hxssank/shaggy/hardware/pcb/preview/shaggy-3d.png

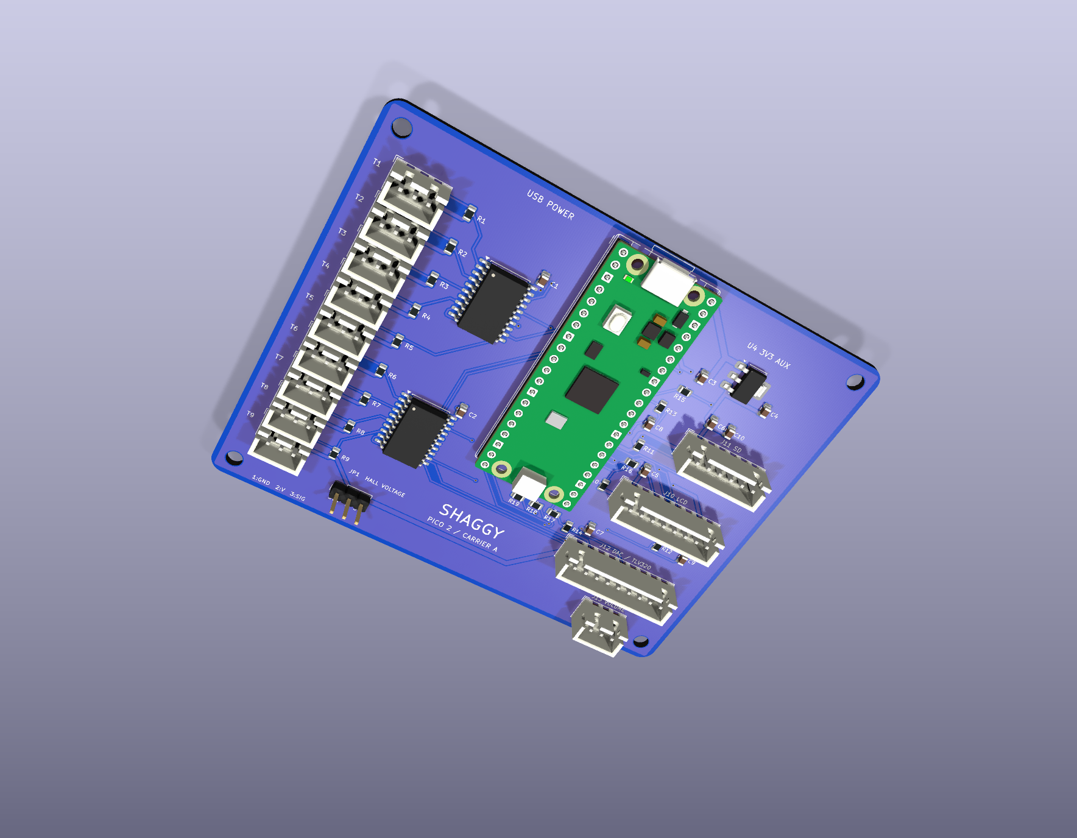
hardware/pcb/preview/shaggy-3d.png
