hxssank/shaggy/hardware/pcb/preview/shaggy-top.png

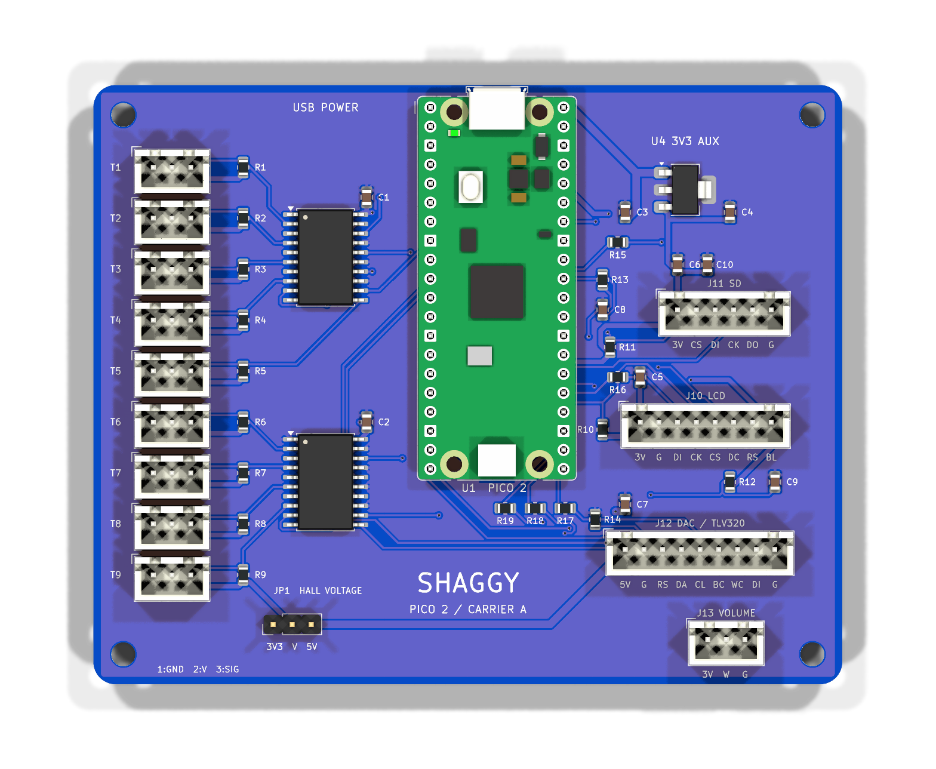
hardware/pcb/preview/shaggy-top.png
