hxssank/shaggy/hardware/pcb/shaggy-carrier.step

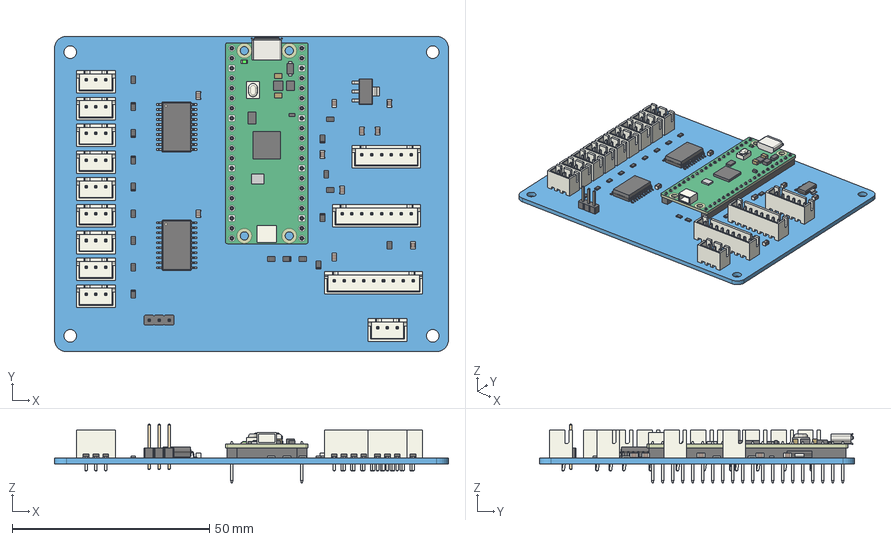
[picture p3: CAD file, 2026-11-09]
hardware/pcb/shaggy-carrier.step
100.0 x 80.0 x 14.9 mm
SOIC-20W_7.5x12.8mm_P1.27mm x 2
R_0805_2012Metric x 19
C_0805_2012Metric x 10
JST_B3B_XH_A x 10
SOT-223
RaspberryPi_Pico_H_Module_KiCad
RaspberryPi_Pico_Header_DIP-40_H2.54mm_KiCad
JST_B9B_XH_A
PinHeader_1x03_P254mm_Vertical
JST_B6B_XH_A
JST_B8B_XH_A
shaggy-carrier_PCB
