hxssank/shaggy/(list of files, drawings)

Other design files:
hardware/pcb/reports/pcb-drc.json
hardware/pcb/reports/schematic-erc.json
