hxssank/shaggy/hardware/pcb/shaggy-carrier.kicad_pcb

## KiCad design hardware/pcb/shaggy-carrier.kicad_pcb (2026-11-09)

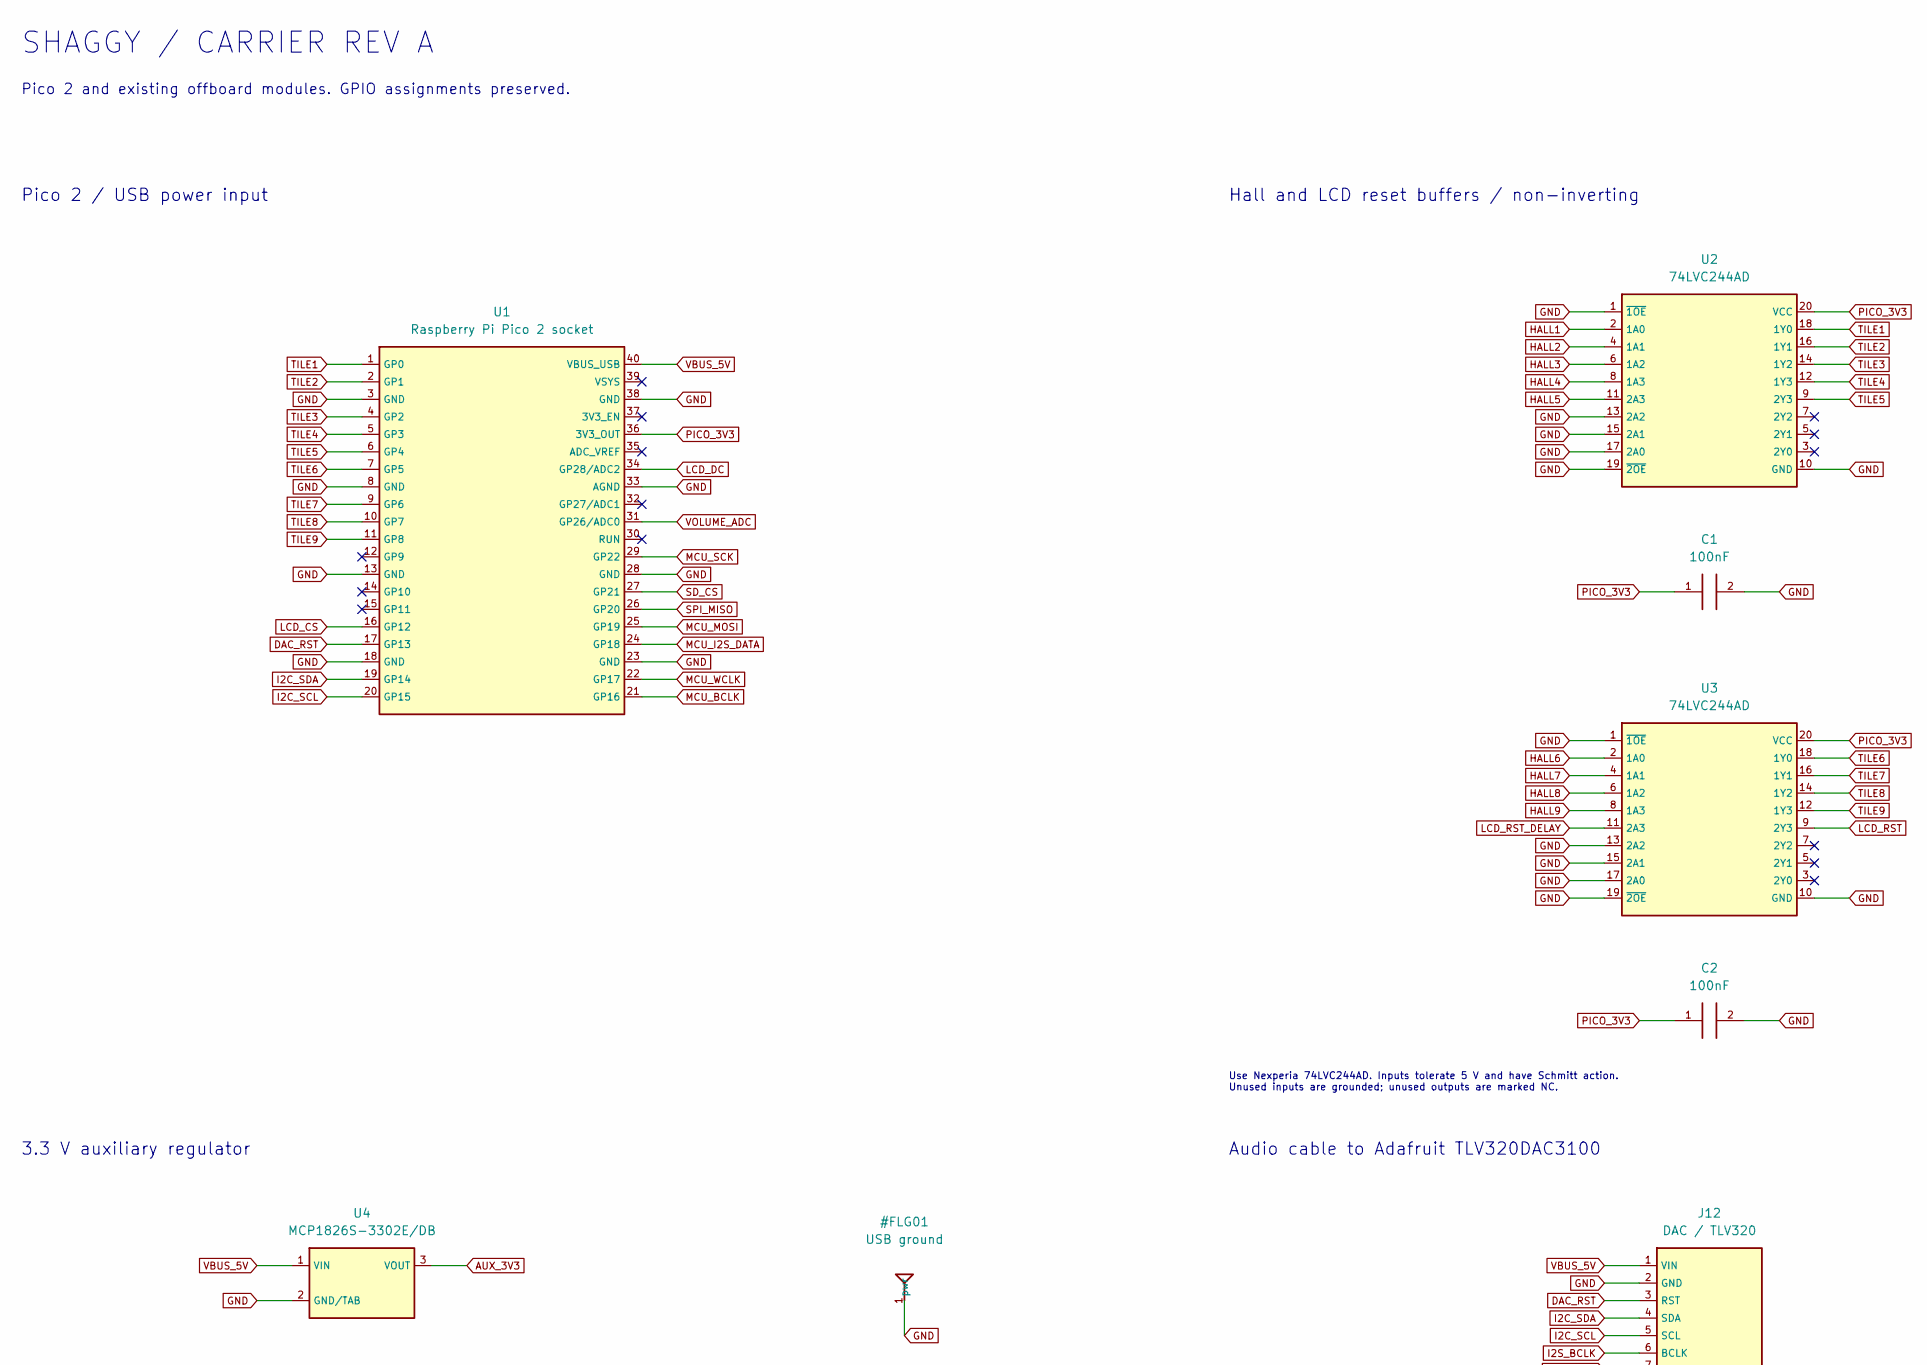
[picture p5: schematic shaggy-carrier.kicad_sch, Shaggy breadboard replacement, part in row 1, column 1]

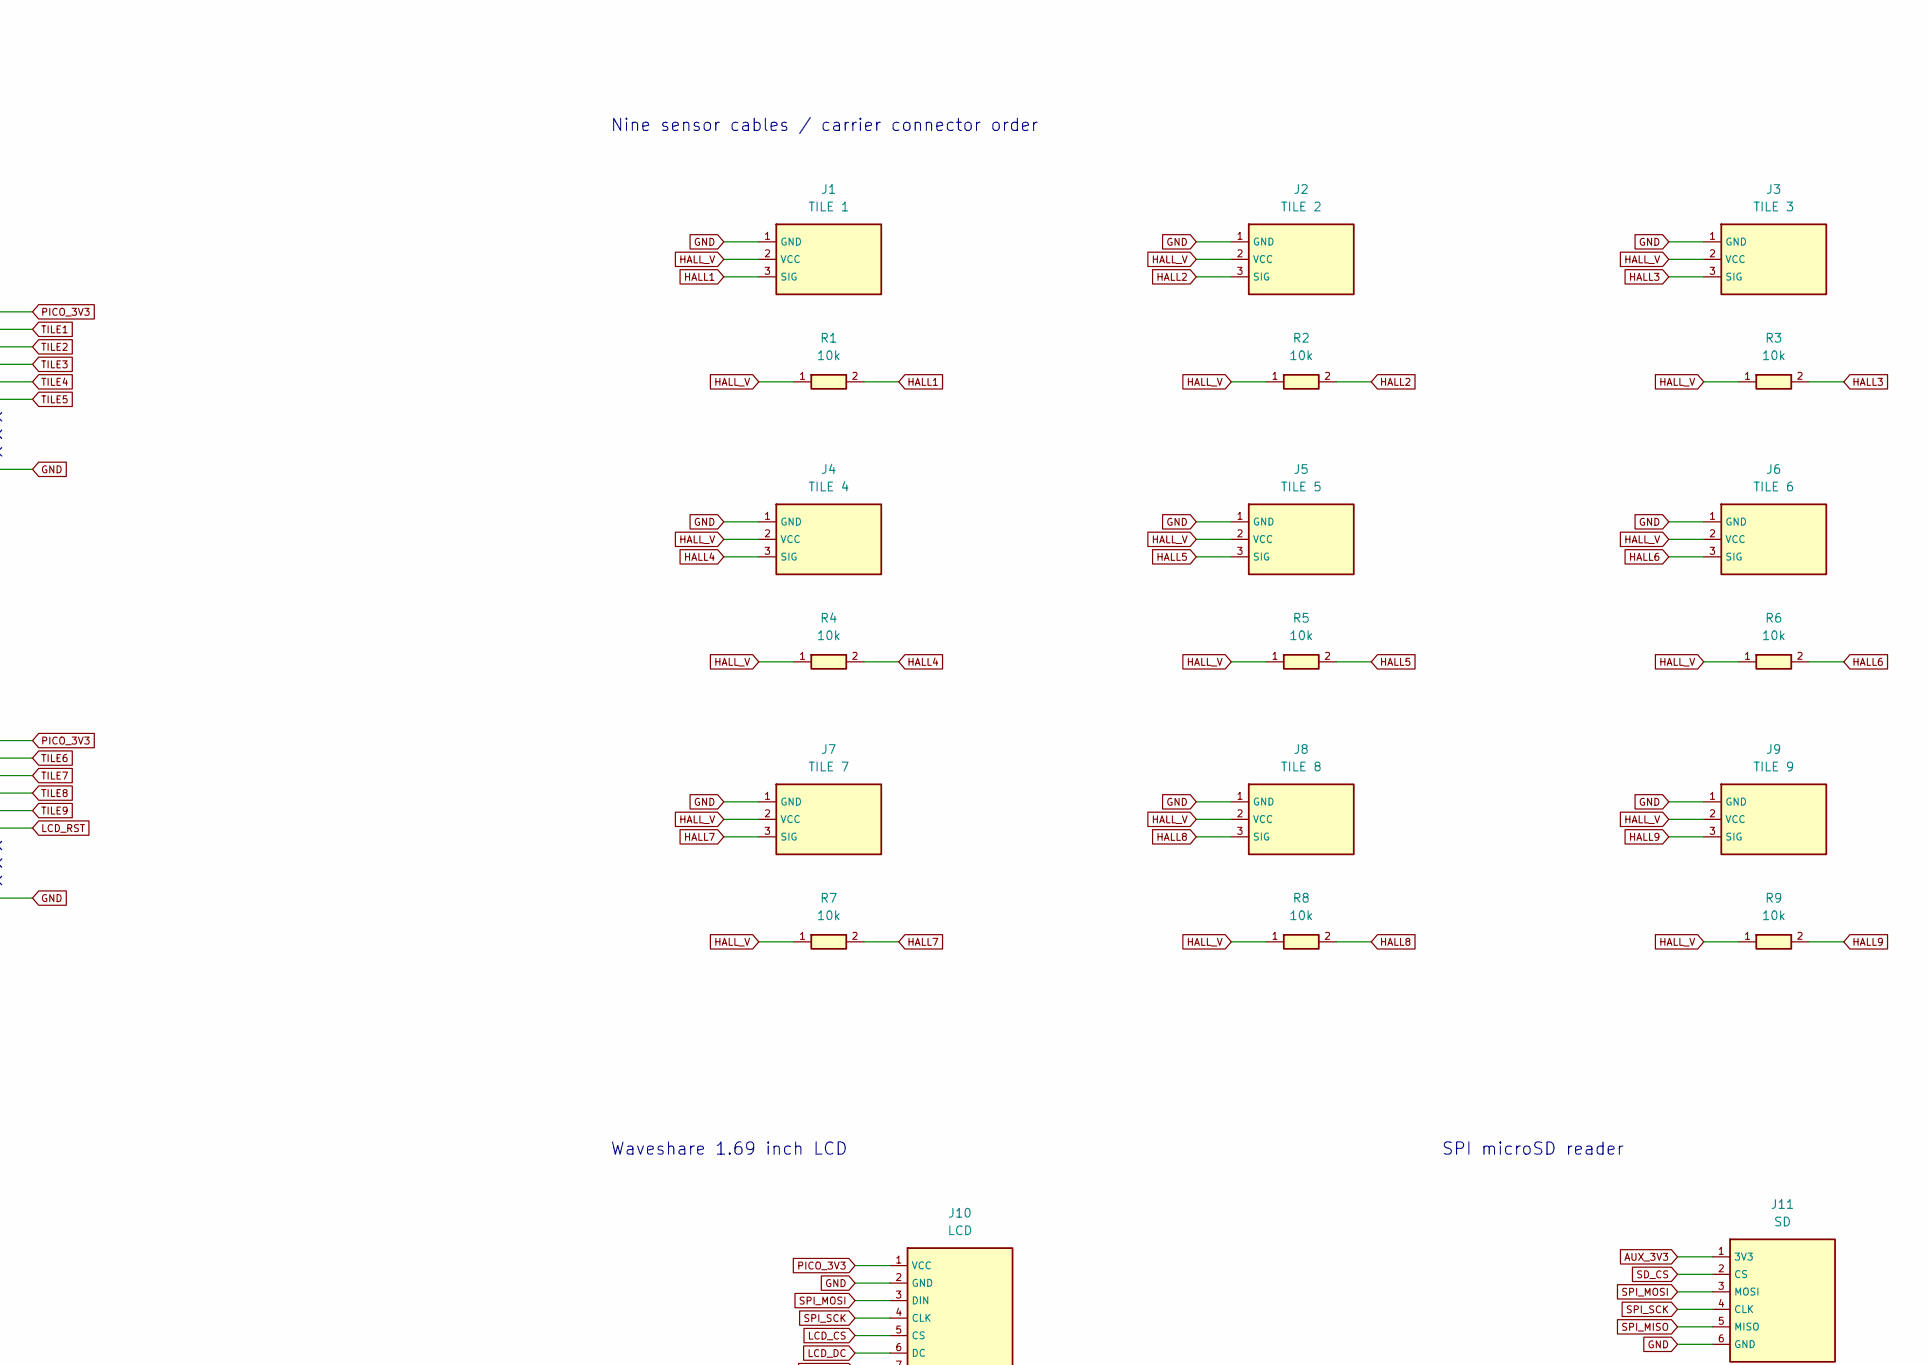
[picture p6: schematic shaggy-carrier.kicad_sch, Shaggy breadboard replacement, part in row 1, column 2]

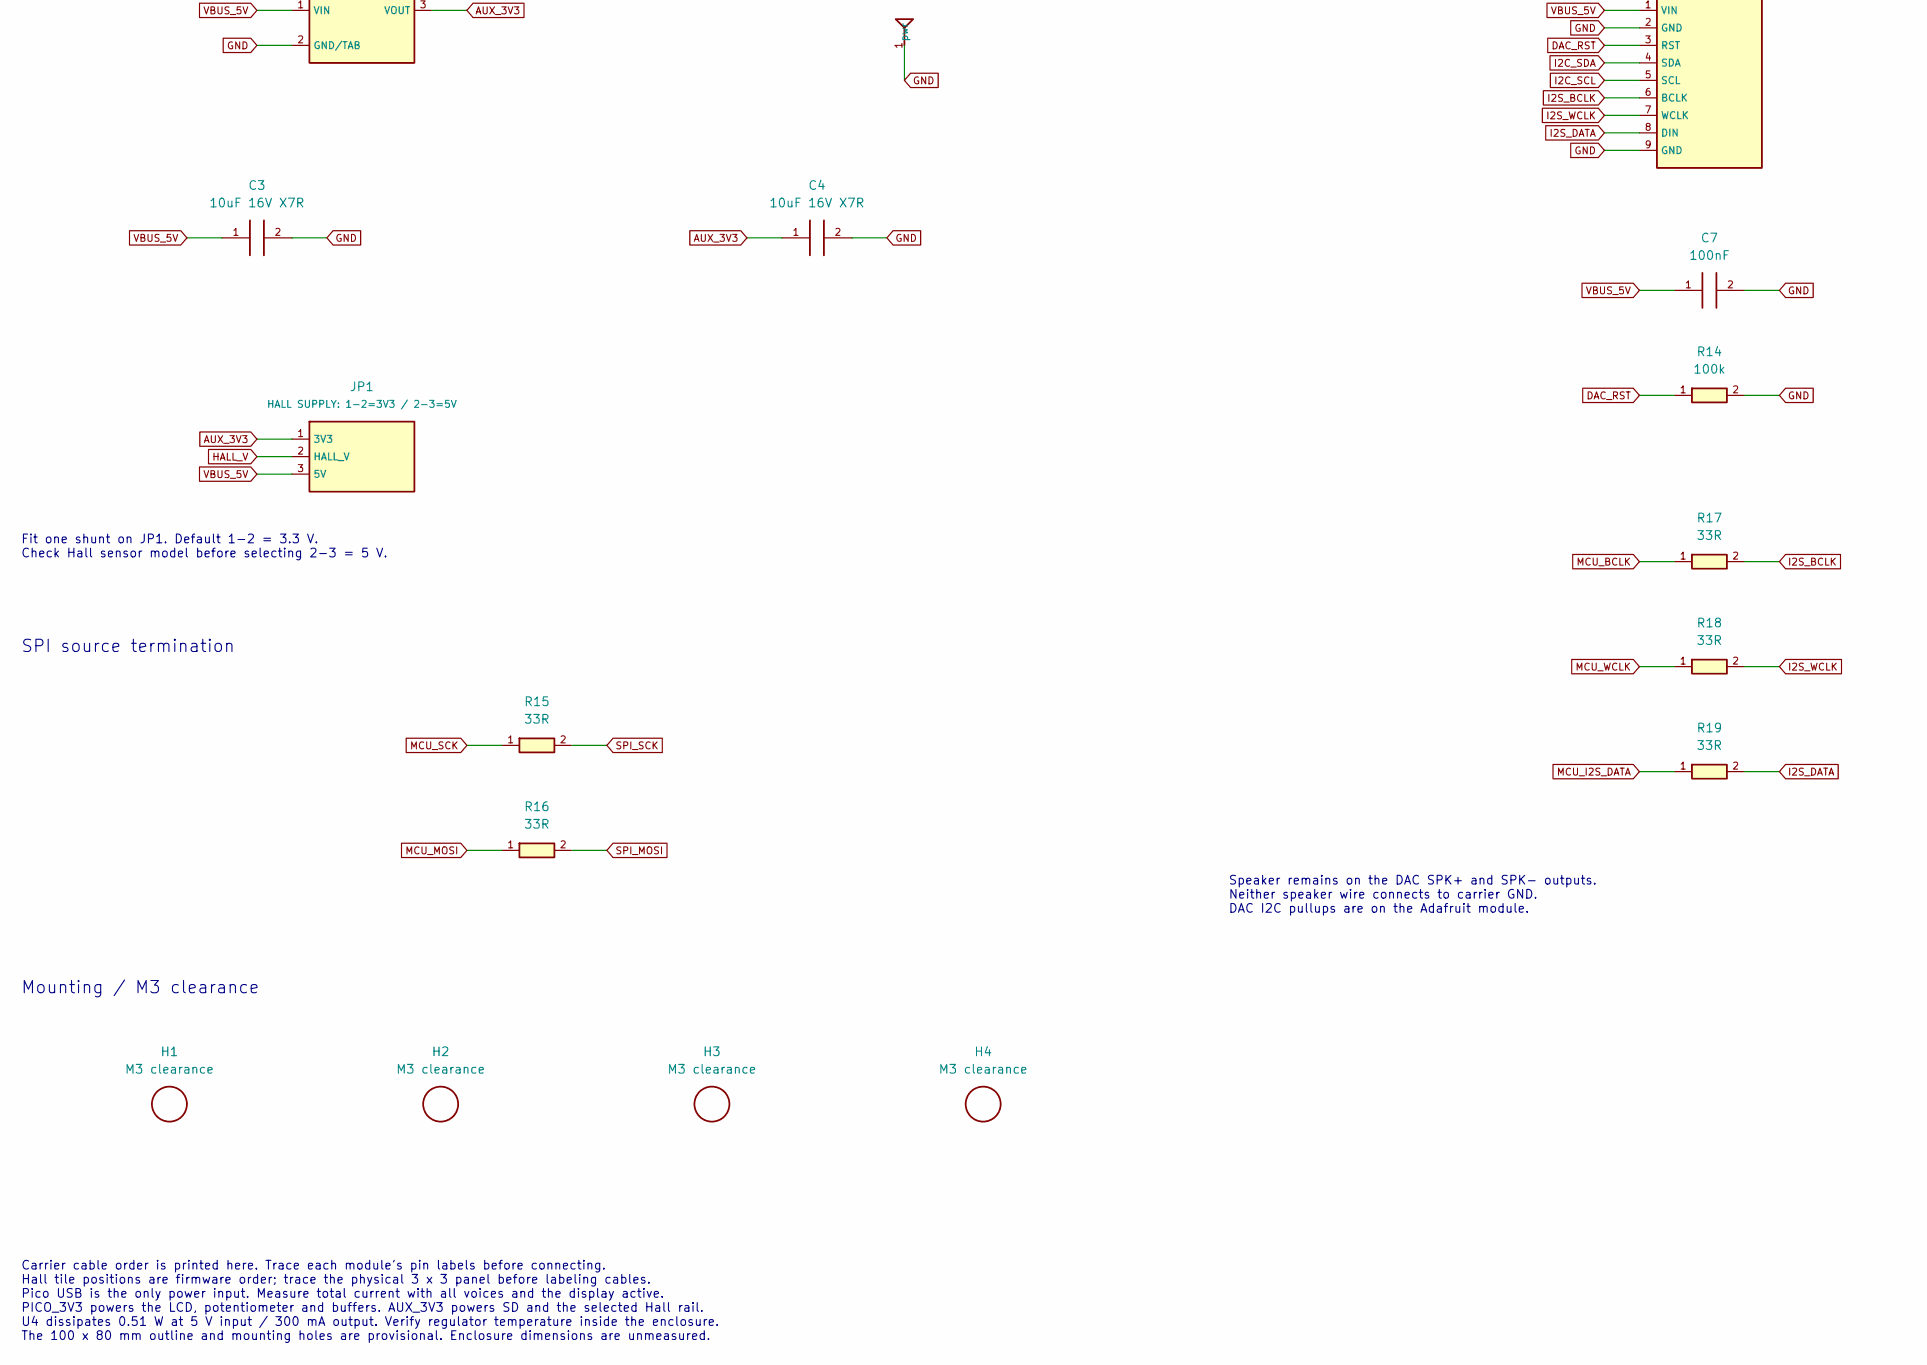
[picture p7: schematic shaggy-carrier.kicad_sch, Shaggy breadboard replacement, part in row 2, column 1]

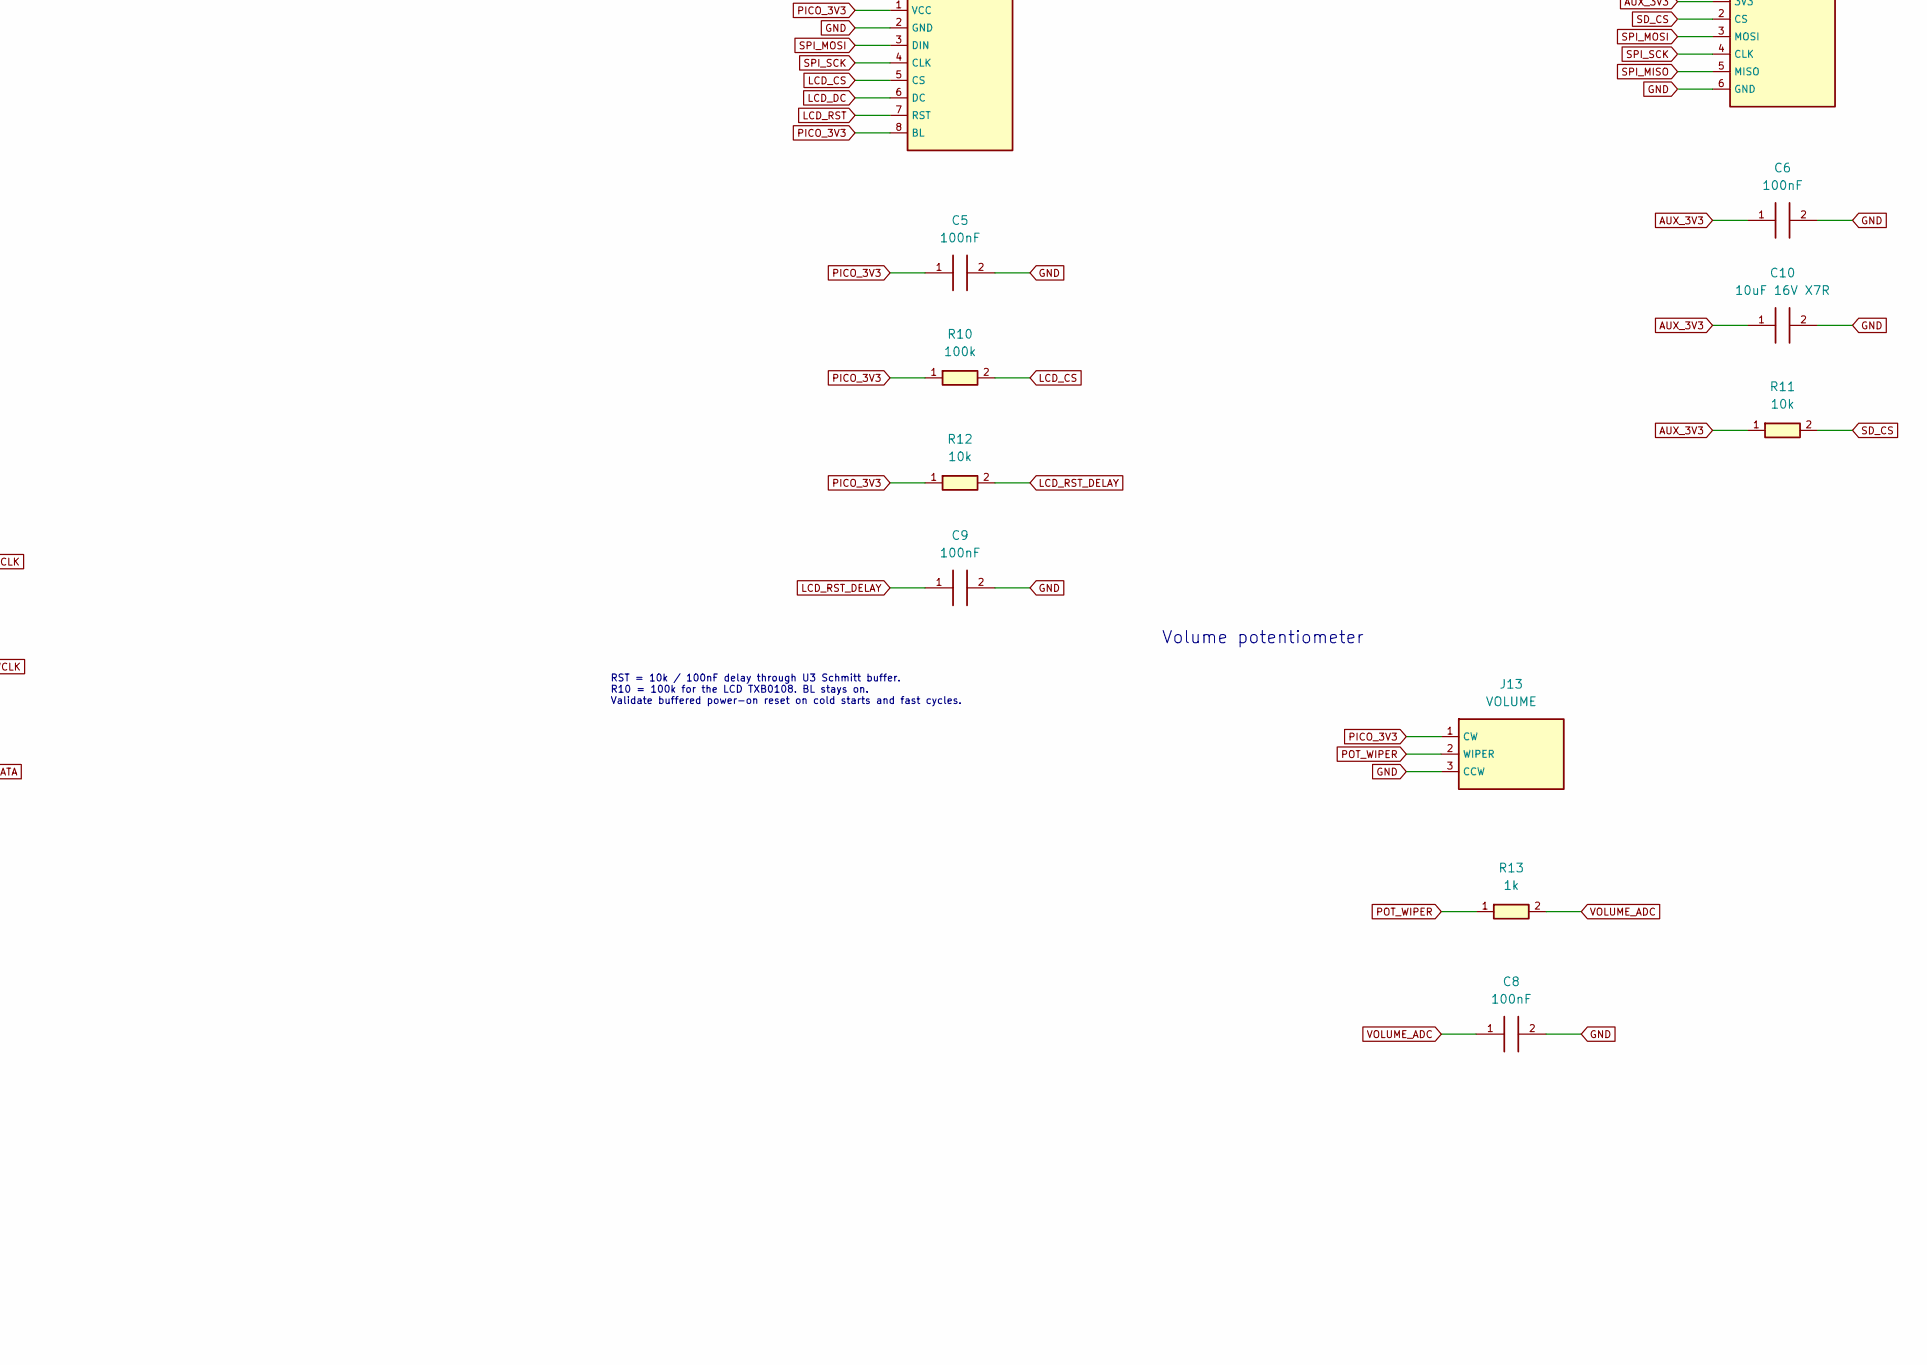
[picture p8: schematic shaggy-carrier.kicad_sch, Shaggy breadboard replacement, part in row 2, column 2]

Parts:
C1, C2, C5, C6, C7, C8, C9: 100nF; C_0805_2012Metric
C3, C4, C10: 10uF 16V X7R; C_0805_2012Metric
H1, H2, H3, H4: M3 clearance; MountingHole_3.2mm_M3
J1: TILE 1; JST_XH_B3B-XH-A_1x03_P2.50mm_Vertical
J2: TILE 2; JST_XH_B3B-XH-A_1x03_P2.50mm_Vertical
J3: TILE 3; JST_XH_B3B-XH-A_1x03_P2.50mm_Vertical
J4: TILE 4; JST_XH_B3B-XH-A_1x03_P2.50mm_Vertical
J5: TILE 5; JST_XH_B3B-XH-A_1x03_P2.50mm_Vertical
J6: TILE 6; JST_XH_B3B-XH-A_1x03_P2.50mm_Vertical
J7: TILE 7; JST_XH_B3B-XH-A_1x03_P2.50mm_Vertical
J8: TILE 8; JST_XH_B3B-XH-A_1x03_P2.50mm_Vertical
J9: TILE 9; JST_XH_B3B-XH-A_1x03_P2.50mm_Vertical
J10: LCD; JST_XH_B8B-XH-A_1x08_P2.50mm_Vertical
J11: SD; JST_XH_B6B-XH-A_1x06_P2.50mm_Vertical
J12: DAC / TLV320; JST_XH_B9B-XH-A_1x09_P2.50mm_Vertical
J13: VOLUME; JST_XH_B3B-XH-A_1x03_P2.50mm_Vertical
JP1: HALL SUPPLY: 1-2=3V3 / 2-3=5V; PinHeader_1x03_P2.54mm_Vertical
R1, R2, R3, R4, R5, R6, R7, R8, R9, R11, R12: 10k; R_0805_2012Metric
R10, R14: 100k; R_0805_2012Metric
R13: 1k; R_0805_2012Metric
R15, R16, R17, R18, R19: 33R; R_0805_2012Metric
U1: Raspberry Pi Pico 2 socket; RaspberryPi_Pico_Common_THT
U2, U3: 74LVC244AD; SOIC-20W_7.5x12.8mm_P1.27mm
U4: MCP1826S-3302E/DB; SOT-223-3_TabPin2

Connections:
AUX_3V3: C4.1, C6.1, C10.1, J11.1 (3V3), JP1.1 (3V3), R11.1, U4.3 (VOUT)
DAC_RST: J12.3 (RST), R14.1, U1.17 (GP13)
GND: C1.2, C2.2, C3.2, C4.2, C5.2, C6.2, C7.2, C8.2, C9.2, C10.2, J1.1 (GND), J2.1 (GND), J3.1 (GND), J4.1 (GND), J5.1 (GND), J6.1 (GND), J7.1 (GND), J8.1 (GND), J9.1 (GND), J10.2 (GND), J11.6 (GND), J12.2 (GND), J12.9 (GND), J13.3 (CCW), R14.2, U1.3 (GND), U1.8 (GND), U1.13 (GND), U1.18 (GND), U1.23 (GND), U1.28 (GND), U1.33 (AGND), U1.38 (GND), U2.1 (~1OE), U2.10 (GND), U2.13 (2A2), U2.15 (2A1), U2.17 (2A0), U2.19 (~2OE), U3.1 (~1OE), U3.10 (GND), U3.13 (2A2), U3.15 (2A1), U3.17 (2A0), U3.19 (~2OE), U4.2 (GND/TAB)
HALL1: J1.3 (SIG), R1.2, U2.2 (1A0)
HALL2: J2.3 (SIG), R2.2, U2.4 (1A1)
HALL3: J3.3 (SIG), R3.2, U2.6 (1A2)
HALL4: J4.3 (SIG), R4.2, U2.8 (1A3)
HALL5: J5.3 (SIG), R5.2, U2.11 (2A3)
HALL6: J6.3 (SIG), R6.2, U3.2 (1A0)
HALL7: J7.3 (SIG), R7.2, U3.4 (1A1)
HALL8: J8.3 (SIG), R8.2, U3.6 (1A2)
HALL9: J9.3 (SIG), R9.2, U3.8 (1A3)
HALL_V: J1.2 (VCC), J2.2 (VCC), J3.2 (VCC), J4.2 (VCC), J5.2 (VCC), J6.2 (VCC), J7.2 (VCC), J8.2 (VCC), J9.2 (VCC), JP1.2 (HALL_V), R1.1, R2.1, R3.1, R4.1, R5.1, R6.1, R7.1, R8.1, R9.1
I2C_SCL: J12.5 (SCL), U1.20 (GP15)
I2C_SDA: J12.4 (SDA), U1.19 (GP14)
I2S_BCLK: J12.6 (BCLK), R17.2
I2S_DATA: J12.8 (DIN), R19.2
I2S_WCLK: J12.7 (WCLK), R18.2
LCD_CS: J10.5 (CS), R10.2, U1.16 (GP12)
LCD_DC: J10.6 (DC), U1.34 (GP28/ADC2)
LCD_RST: J10.7 (RST), U3.9 (2Y3)
LCD_RST_DELAY: C9.1, R12.2, U3.11 (2A3)
MCU_BCLK: R17.1, U1.21 (GP16)
MCU_I2S_DATA: R19.1, U1.24 (GP18)
MCU_MOSI: R16.1, U1.25 (GP19)
MCU_SCK: R15.1, U1.29 (GP22)
MCU_WCLK: R18.1, U1.22 (GP17)
PICO_3V3: C1.1, C2.1, C5.1, J10.1 (VCC), J10.8 (BL), J13.1 (CW), R10.1, R12.1, U1.36 (3V3_OUT), U2.20 (VCC), U3.20 (VCC)
POT_WIPER: J13.2 (WIPER), R13.1
SD_CS: J11.2 (CS), R11.2, U1.27 (GP21)
SPI_MISO: J11.5 (MISO), U1.26 (GP20)
SPI_MOSI: J10.3 (DIN), J11.3 (MOSI), R16.2
SPI_SCK: J10.4 (CLK), J11.4 (CLK), R15.2
TILE1: U1.1 (GP0), U2.18 (1Y0)
TILE2: U1.2 (GP1), U2.16 (1Y1)
TILE3: U1.4 (GP2), U2.14 (1Y2)
TILE4: U1.5 (GP3), U2.12 (1Y3)
TILE5: U1.6 (GP4), U2.9 (2Y3)
TILE6: U1.7 (GP5), U3.18 (1Y0)
TILE7: U1.9 (GP6), U3.16 (1Y1)
TILE8: U1.10 (GP7), U3.14 (1Y2)
TILE9: U1.11 (GP8), U3.12 (1Y3)
VBUS_5V: C3.1, C7.1, J12.1 (VIN), JP1.3 (5V), U1.40 (VBUS_USB), U4.1 (VIN)
VOLUME_ADC: C8.1, R13.2, U1.31 (GP26/ADC0)

Notes on the sheet:
SHAGGY / CARRIER REV A
Pico 2 and existing offboard modules. GPIO assignments preserved.
Pico 2 / USB power input
Hall and LCD reset buffers / non-inverting
Nine sensor cables / carrier connector order
3.3 V auxiliary regulator
Audio cable to Adafruit TLV320DAC3100
Waveshare 1.69 inch LCD
SPI microSD reader
Volume potentiometer
SPI source termination
Mounting / M3 clearance
Fit one shunt on JP1. Default 1-2 = 3.3 V. Check Hall sensor model before selecting 2-3 = 5 V.
Use Nexperia 74LVC244AD. Inputs tolerate 5 V and have Schmitt action. Unused inputs are grounded; unused outputs are marked NC.
Speaker remains on the DAC SPK+ and SPK- outputs. Neither speaker wire connects to carrier GND. DAC I2C pullups are on the Adafruit module.
RST = 10k / 100nF delay through U3 Schmitt buffer. R10 = 100k for the LCD TXB0108. BL stays on. Validate buffered power-on reset on cold starts and fast cycles.
Carrier cable order is printed here. Trace each module's pin labels before connecting. Hall tile positions are firmware order; trace the physical 3 x 3 panel before labeling cables. Pico USB is the only power input. Measure total current with all voices and the display active. PICO_3V3 powers the L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

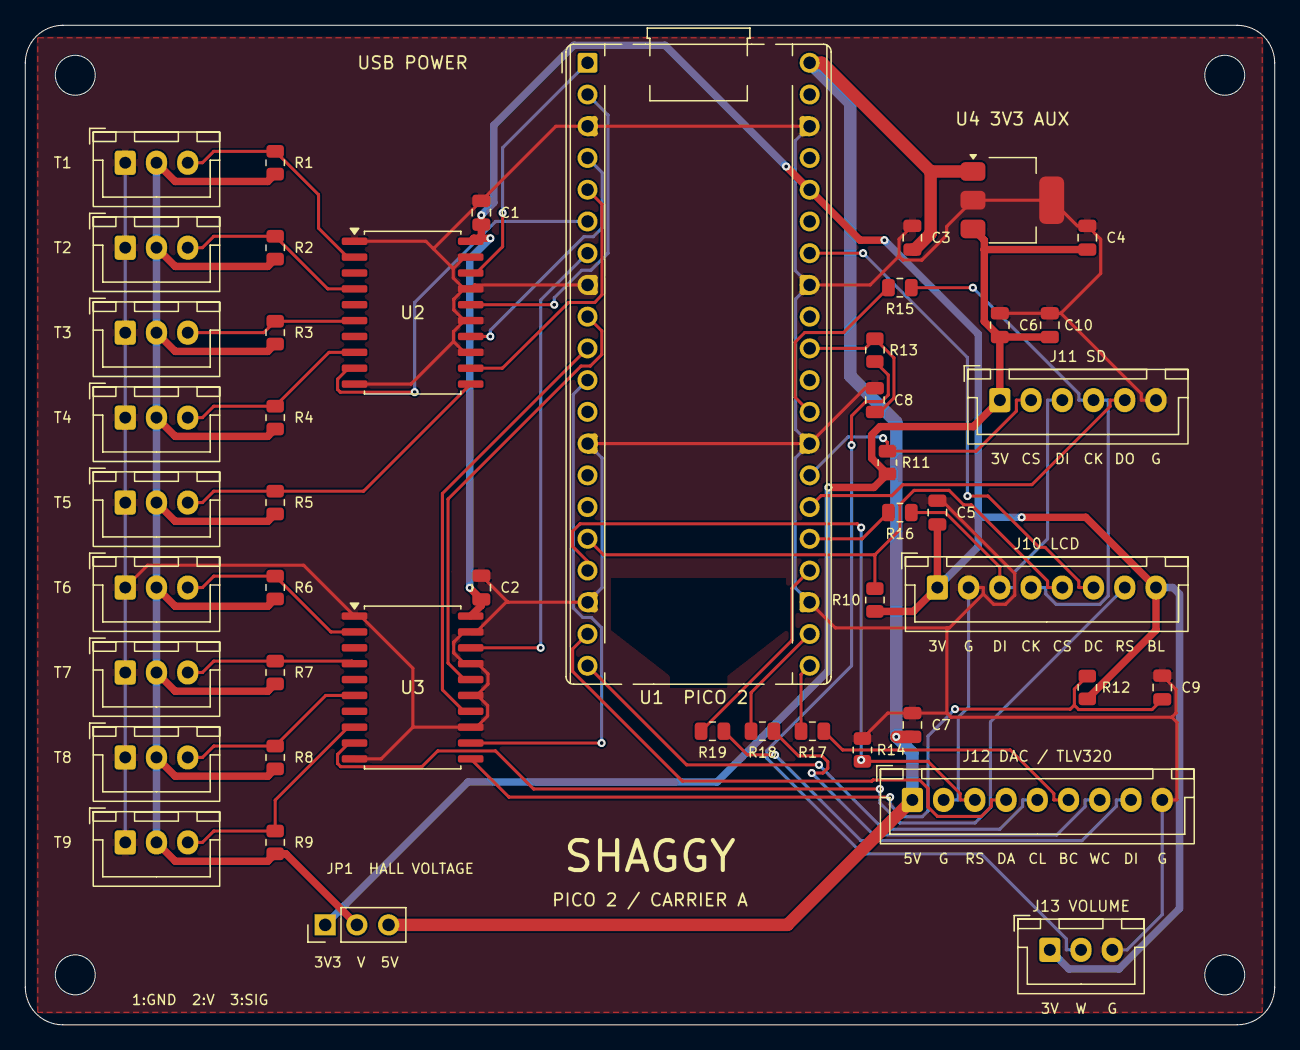
[picture p9: board shaggy-carrier.kicad_pcb from above]

Board: 2 copper layers, 100.0 x 80.0 mm, 51 parts (0 on the bottom side), 44 nets.
