hxssank/shaggy/(commit log)

2026-11-09 Publish reviewed source with setup and validation notes
    [bom.csv, cable-pinout.csv, schematic-erc.json, shaggy-carrier.kicad_pcb, shaggy-carrier.kicad_sch]
2026-11-09 docs: publish CAD and fabrication files with parts and validation scope
    [pcb-drc.json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]
